JorgenSteen/BreakoutBodger-2-electric-boogaloo/Atmega_328_breakout.png

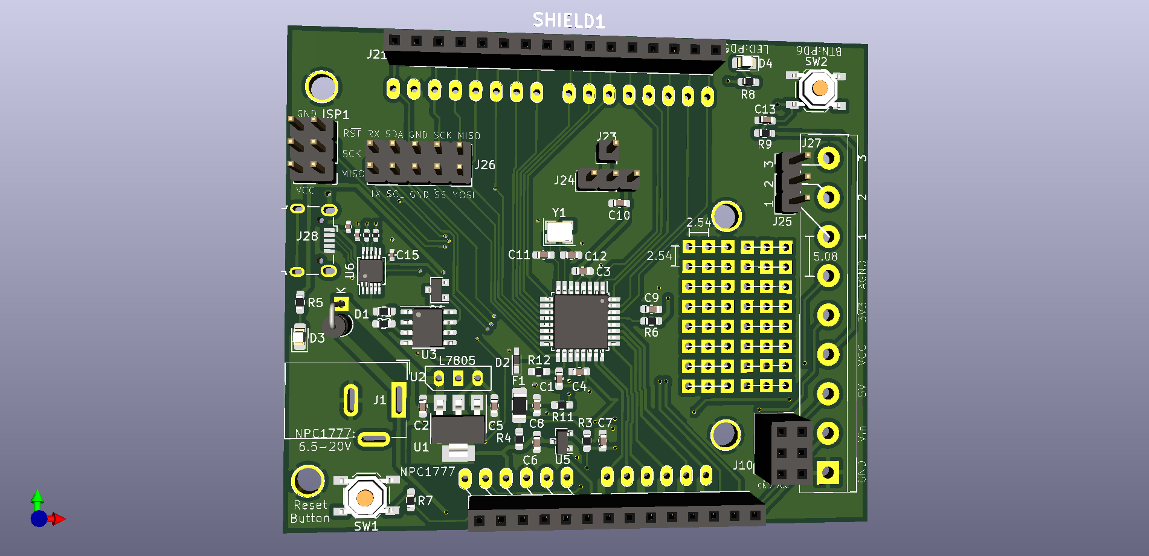
Atmega_328_breakout.png
