JorgenSteen/BreakoutBodger-2-electric-boogaloo/src/Kicad/report.txt

Updated GND from #PWR27 to #PWR027
Updated GND from #PWR19 to #PWR019
Updated VCC from #PWR20 to #PWR020
Updated GND from #PWR21 to #PWR021
Updated GND from #PWR22 to #PWR022
Updated GND from #PWR23 to #PWR023
Updated VCC from #PWR24 to #PWR024
Updated GND from #PWR25 to #PWR025
Updated GND from #PWR26 to #PWR026
Updated VCC from #PWR18 to #PWR018
Updated GND from #PWR28 to #PWR028
Updated VCC from #PWR29 to #PWR029
Updated GND from #PWR30 to #PWR030
Updated GND from #PWR31 to #PWR031
Updated VCC from #PWR32 to #PWR032
Updated GND from #PWR33 to #PWR033
Updated GND from #PWR34 to #PWR034
Updated GND from #PWR10 to #PWR010
Updated GND from #PWR2 to #PWR02
Updated GND from #PWR3 to #PWR03
Updated VCC from #PWR4 to #PWR04
Updated GND from #PWR5 to #PWR05
Updated GND from #PWR6 to #PWR06
Updated +5V from #PWR7 to #PWR07
Updated +5V from #PWR8 to #PWR08
Updated GND from #PWR9 to #PWR09
Updated GND from #PWR1 to #PWR01
Updated +5V from #PWR11 to #PWR011
Updated +5V from #PWR12 to #PWR012
Updated +3.3V from #PWR13 to #PWR013
Updated GND from #PWR14 to #PWR014
Updated GND from #PWR15 to #PWR015
Updated +3.3V from #PWR16 to #PWR016
Updated +5V from #PWR17 to #PWR017
