JorgenSteen/BreakoutBodger-2-electric-boogaloo/3D print box/BB_case_top.stl

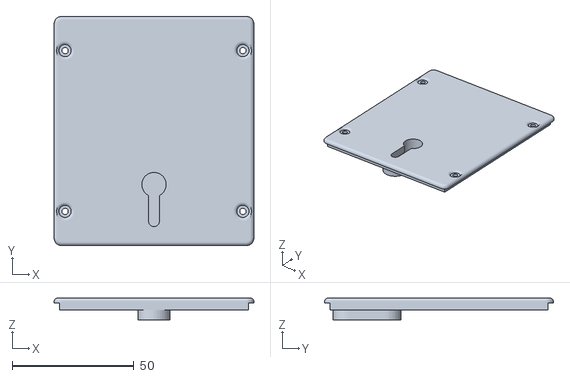
[picture p3: CAD file, 2020-11-07]
3D print box/BB_case_top.stl
82.0 x 94.0 x 9.00
