JorgenSteen/BreakoutBodger-2-electric-boogaloo/(list of files, cad)

Other CAD files:
src/Fusion360/BreakoutBodger_case v66.f3d
