JorgenSteen/BreakoutBodger-2-electric-boogaloo/Schematics.pdf

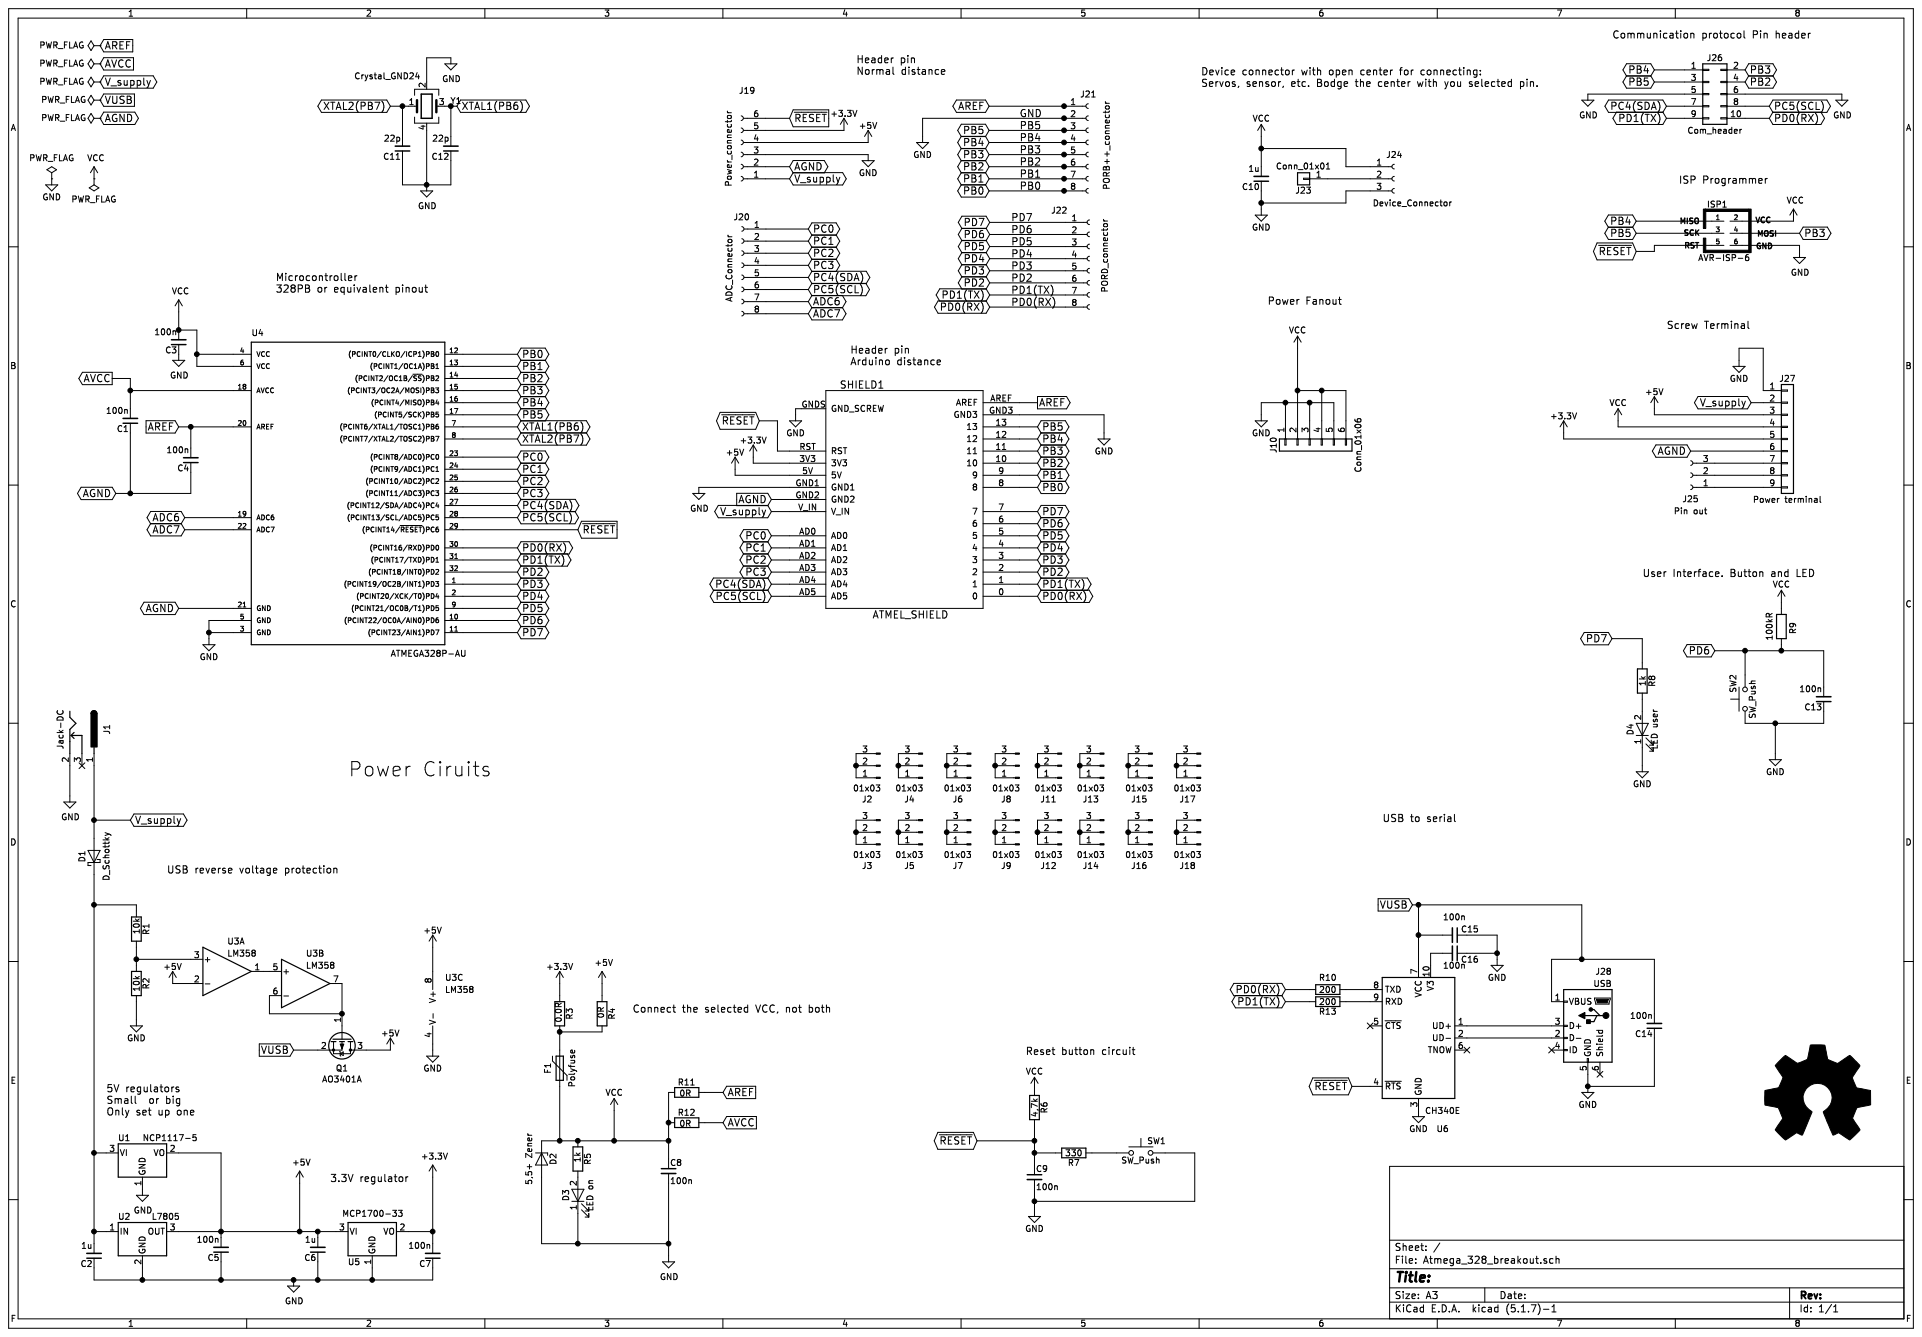
[picture p4: page 1]
