JorgenSteen/BreakoutBodger-2-electric-boogaloo/src/Kicad/Atmega_328_breakout.kicad_pcb

## KiCad design src/Kicad/Atmega_328_breakout.kicad_pcb (2020-11-07)

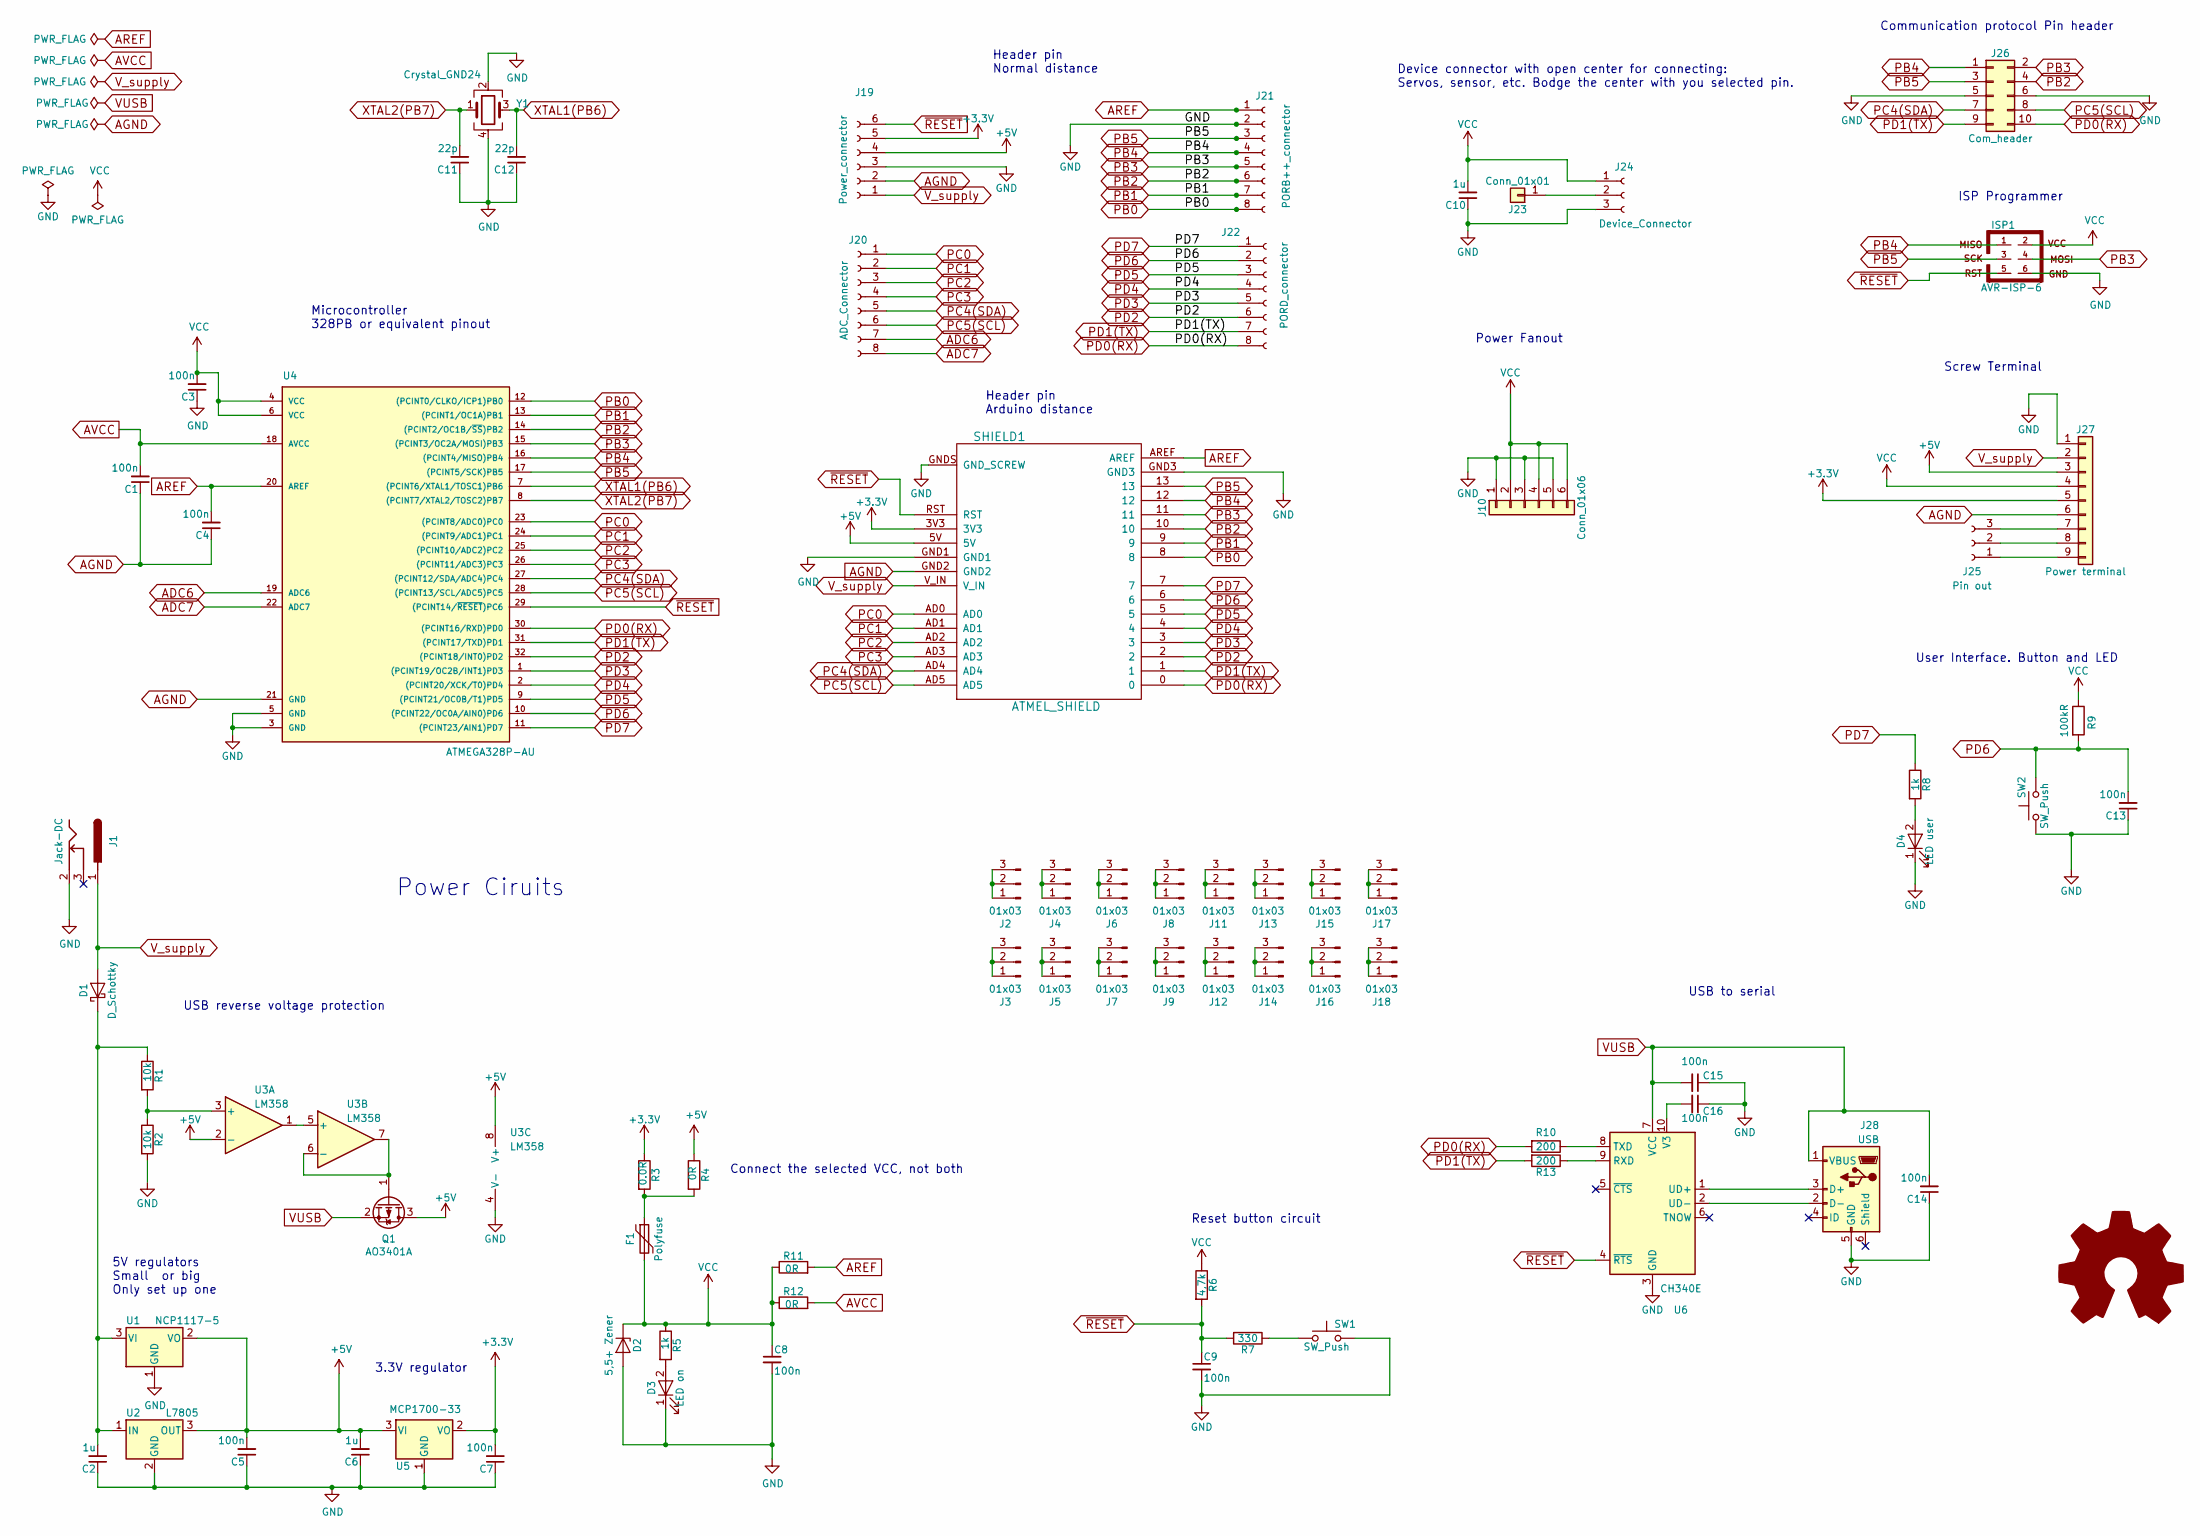
[picture p5: schematic Atmega_328_breakout.sch]

Parts:
C1, C3, C4, C5, C7, C8, C9, C13: 100n; C_0603_1608Metric_Pad1.08x0.95mm_HandSolder; LCSC C14663
C2, C6, C10: 1u; C_0603_1608Metric_Pad1.08x0.95mm_HandSolder; LCSC C15849
C11, C12: 22p; C_0603_1608Metric_Pad1.08x0.95mm_HandSolder; LCSC C1653
C14, C15, C16: 100n; C_0402_1005Metric; LCSC C1525
D1: D_Schottky; D_A-405_P2.54mm_Vertical_KathodeUp
D2: 5,5+ Zener; D_SC-80_HandSoldering; LCSC C8062
D3: LED on; LED_0805_2012Metric_Pad1.15x1.40mm_HandSolder; LCSC C2297
D4: LED user; LED_0805_2012Metric_Pad1.15x1.40mm_HandSolder; LCSC C2293
F1: Polyfuse; Fuse_1206_3216Metric_Pad1.42x1.75mm_HandSolder; LCSC C66453
ISP1: AVR-ISP-6; PinHeader_2x03_P2.54mm_Vertical
J1: Jack-DC; BarrelJack_Wuerth_6941xx301002
J2, J3, J4, J5, J6, J7, J8, J9, J11, J12, J13, J14, J15, J16, J17, J18: 01x03; conn_01x03_square
J10: Conn_01x06; PinSocket_2x03_P2.54mm_Vertical
J19: Power_connector; PinSocket_1x06_P2.54mm_Vertical
J20: ADC_Connector; PinSocket_1x08_P2.54mm_Vertical
J21: PORB++_connector; PinSocket_1x08_P2.54mm_Vertical
J22: PORD_connector; PinSocket_1x08_P2.54mm_Vertical
J23: Conn_01x01; PinHeader_1x01_P2.54mm_Vertical
J24: Device_Connector; PinHeader_1x03_P2.54mm_Vertical
J25: Pin out; PinHeader_1x03_P2.54mm_Vertical
J26: Com_header; PinHeader_2x05_P2.54mm_Vertical
J27: Power terminal; TerminalBlock_bornier-9_P5.08mm
J28: USB; USB_Micro-B_Wuerth_629105150521
LOGO1: Logo_Open_Hardware_Large; BB2QR
Q1: AO3401A; SOT-23; LCSC C15127
R1, R2: 10k; R_0603_1608Metric_Pad0.98x0.95mm_HandSolder; LCSC C25804
R3: 0.0R; R_0603_1608Metric_Pad0.98x0.95mm_HandSolder
R4, R11, R12: 0R; R_0603_1608Metric_Pad0.98x0.95mm_HandSolder; LCSC C21189
R5, R8: 1k; R_0603_1608Metric_Pad0.98x0.95mm_HandSolder; LCSC C21190
R6: 4,7k; R_0603_1608Metric_Pad0.98x0.95mm_HandSolder; LCSC C23162
R7: 330; R_0603_1608Metric_Pad0.98x0.95mm_HandSolder; LCSC C23138
R9: 100kR; R_0603_1608Metric_Pad0.98x0.95mm_HandSolder; LCSC C25803
R10, R13: 200; R_0402_1005Metric; LCSC C25087
SHIELD1: ATMEL_SHIELD; AtmelSHIELD
SW1, SW2: SW_Push; SW_SPST_TL3342; LCSC C318887
U1: NCP1117-5; SOT-223-3_TabPin2; LCSC C17314
U2: L7805; TO-220-ver2
U3: LM358; SOIC-8_3.9x4.9mm_P1.27mm; LCSC C7950
U4: ATMEGA328P-AU; TQFP-32_7x7mm_P0.8mm; LCSC C14877
U5: MCP1700-33; SOT-23; LCSC C62244
U6: CH340E; MSOP-10_3x3mm_P0.5mm
Y1: Crystal_GND24; Crystal_SMD_3225-4Pin_3.2x2.5mm; LCSC C13738

Connections:
+3V3: C7.2, J19.5, J27.5, R3.1, SHIELD1.3V3, U5.2 (VO)
+5V: C5.2, C6.2, J19.4, J27.3, Q1.3 (D), R4.1, SHIELD1.5V, U1.2 (VO), U2.3 (OUT), U3.2 (-), U3.8 (V+), U5.3 (VI)
ADC6: J20.7, U4.19 (ADC6)
ADC7: J20.8, U4.22 (ADC7)
AGND: C1.1, C4.1, J19.2, J27.6, SHIELD1.GND2, U4.21 (GND)
AREF: C4.2, J21.1, R11.2, SHIELD1.AREF, U4.20 (AREF)
AVCC: C1.2, R12.2, U4.18 (AVCC)
GND: C2.1, C3.1, C5.1, C6.1, C7.1, C8.2, C9.2, C10.1, C11.1, C12.1, C13.1, C14.1, C15.1, C16.1, D2.2 (A), D3.1 (K), D4.1 (K), ISP1.6, J1.2, J10.1, J10.3, J10.5, J19.3, J21.2, J24.3, J26.5, J26.6, J27.1, J28.5 (GND), R2.2, SHIELD1.GND1, SHIELD1.GND3, SHIELD1.GNDS (GND_SCREW), SW1.2, SW2.1, U1.1 (GND), U2.2 (GND), U3.4 (V-), U4.3 (GND), U4.5 (GND), U5.1 (GND), U6.3 (GND), Y1.2, Y1.4
unnamed: C2.2, D1.1 (K), R1.1, U1.3 (VI), U2.1 (IN)
unnamed: C16.2, U6.10 (V3)
unnamed: D3.2 (A), R5.2
unnamed: D4.2 (A), R8.2
unnamed: F1.1, R3.2, R4.2
unnamed: J2.1, J2.2, J2.3
unnamed: J3.1, J3.2, J3.3
unnamed: J4.1, J4.2, J4.3
unnamed: J5.1, J5.2, J5.3
unnamed: J6.1, J6.2, J6.3
unnamed: J7.1, J7.2, J7.3
unnamed: J8.1, J8.2, J8.3
unnamed: J9.1, J9.2, J9.3
unnamed: J11.1, J11.2, J11.3
unnamed: J12.1, J12.2, J12.3
unnamed: J13.1, J13.2, J13.3
unnamed: J14.1, J14.2, J14.3
unnamed: J15.1, J15.2, J15.3
unnamed: J16.1, J16.2, J16.3
unnamed: J17.1, J17.2, J17.3
unnamed: J18.1, J18.2, J18.3
unnamed: J23.1, J24.2
unnamed: J25.1, J27.9
unnamed: J25.2, J27.8
unnamed: J25.3, J27.7
unnamed: J28.2 (D-), U6.2 (UD-)
unnamed: J28.3 (D+), U6.1 (UD+)
unnamed: Q1.1 (G), U3.6 (-), U3.7
unnamed: R1.2, R2.1, U3.3 (+)
unnamed: R7.1, SW1.1
unnamed: R10.1, U6.8 (TXD)
unnamed: R13.1, U6.9 (RXD)
unnamed: U3.1, U3.5 (+)
PB0: J21.8, SHIELD1.8, U4.12 ((PCINT0/CLKO/ICP1)PB0)
PB1: J21.7, SHIELD1.9, U4.13 ((PCINT1/OC1A)PB1)
PB2: J21.6, J26.4, SHIELD1.10, U4.14 ((PCINT2/OC1B/~SS~)PB2)
PB3: ISP1.4, J21.5, J26.2, SHIELD1.11, U4.15 ((PCINT3/OC2A/MOSI)PB3)
PB4: ISP1.1, J21.4, J26.1, SHIELD1.12, U4.16 ((PCINT4/MISO)PB4)
PB5: ISP1.3, J21.3, J26.3, SHIELD1.13, U4.17 ((PCINT5/SCK)PB5)
PC0: J20.1, SHIELD1.AD0, U4.23 ((PCINT8/ADC0)PC0)
PC1: J20.2, SHIELD1.AD1, U4.24 ((PCINT9/ADC1)PC1)
PC2: J20.3, SHIELD1.AD2, U4.25 ((PCINT10/ADC2)PC2)
PC3: J20.4, SHIELD1.AD3, U4.26 ((PCINT11/ADC3)PC3)
PC4(SDA): J20.5, J26.7, SHIELD1.AD4, U4.27 ((PCINT12/SDA/ADC4)PC4)
PC5(SCL): J20.6, J26.8, SHIELD1.AD5, U4.28 ((PCINT13/SCL/ADC5)PC5)
PD0(RX): J22.8, J26.10, R10.2, SHIELD1.0, U4.30 ((PCINT16/RXD)PD0)
PD1(TX): J22.7, J26.9, R13.2, SHIELD1.1, U4.31 ((PCINT17/TXD)PD1)
PD2: J22.6, SHIELD1.2, U4.32 ((PCINT18/INT0)PD2)
PD3: J22.5, SHIELD1.3, U4.1 ((PCINT19/OC2B/INT1)PD3)
PD4: J22.4, SHIELD1.4, U4.2 ((PCINT20/XCK/T0)PD4)
PD5: J22.3, SHIELD1.5, U4.9 ((PCINT21/OC0B/T1)PD5)
PD6: C13.2, J22.2, R9.2, SHIELD1.6, SW2.2, U4.10 ((PCINT22/OC0A/AIN0)PD6)
PD7: J22.1, R8.1, SHIELD1.7, U4.11 ((PCINT23/AIN1)PD7)
VCC: C3.2, C8.1, C10.2, D2.1 (K), F1.2, ISP1.2, J10.2, J10.4, J10.6, J24.1, J27.4, R5.1, R6.1, R9.1, R11.1, R12.1, U4.4 (VCC), U4.6 (VCC)
VUSB: C14.2, C15.2, J28.1 (VBUS), Q1.2 (S), U6.7 (VCC)
V_supply: D1.2 (A), J1.1, J19.1, J27.2, SHIELD1.V_IN
XTAL1(PB6): C12.2, U4.7 ((PCINT6/XTAL1/TOSC1)PB6), Y1.3
XTAL2(PB7): C11.2, U4.8 ((PCINT7/XTAL2/TOSC2)PB7), Y1.1
~RESET: C9.1, ISP1.5, J19.6, R6.2, R7.2, SHIELD1.RST, U4.29 ((PCINT14/~RESET~)PC6), U6.4 (~RTS)

Notes on the sheet:
User Interface. Button and LED
Screw Terminal
ISP Programmer
Communication protocol Pin header
Reset button circuit
Connect the selected VCC, not both
USB reverse voltage protection
Power Ciruits
5V regulators Small or big Only set up one
3.3V regulator
Microcontroller 328PB or equivalent pinout
Header pin Arduino distance
Header pin Normal distance
Device connector with open center for connecting: Servos, sensor, etc. Bodge the center with you selected pin.
Power Fanout
USB to serial

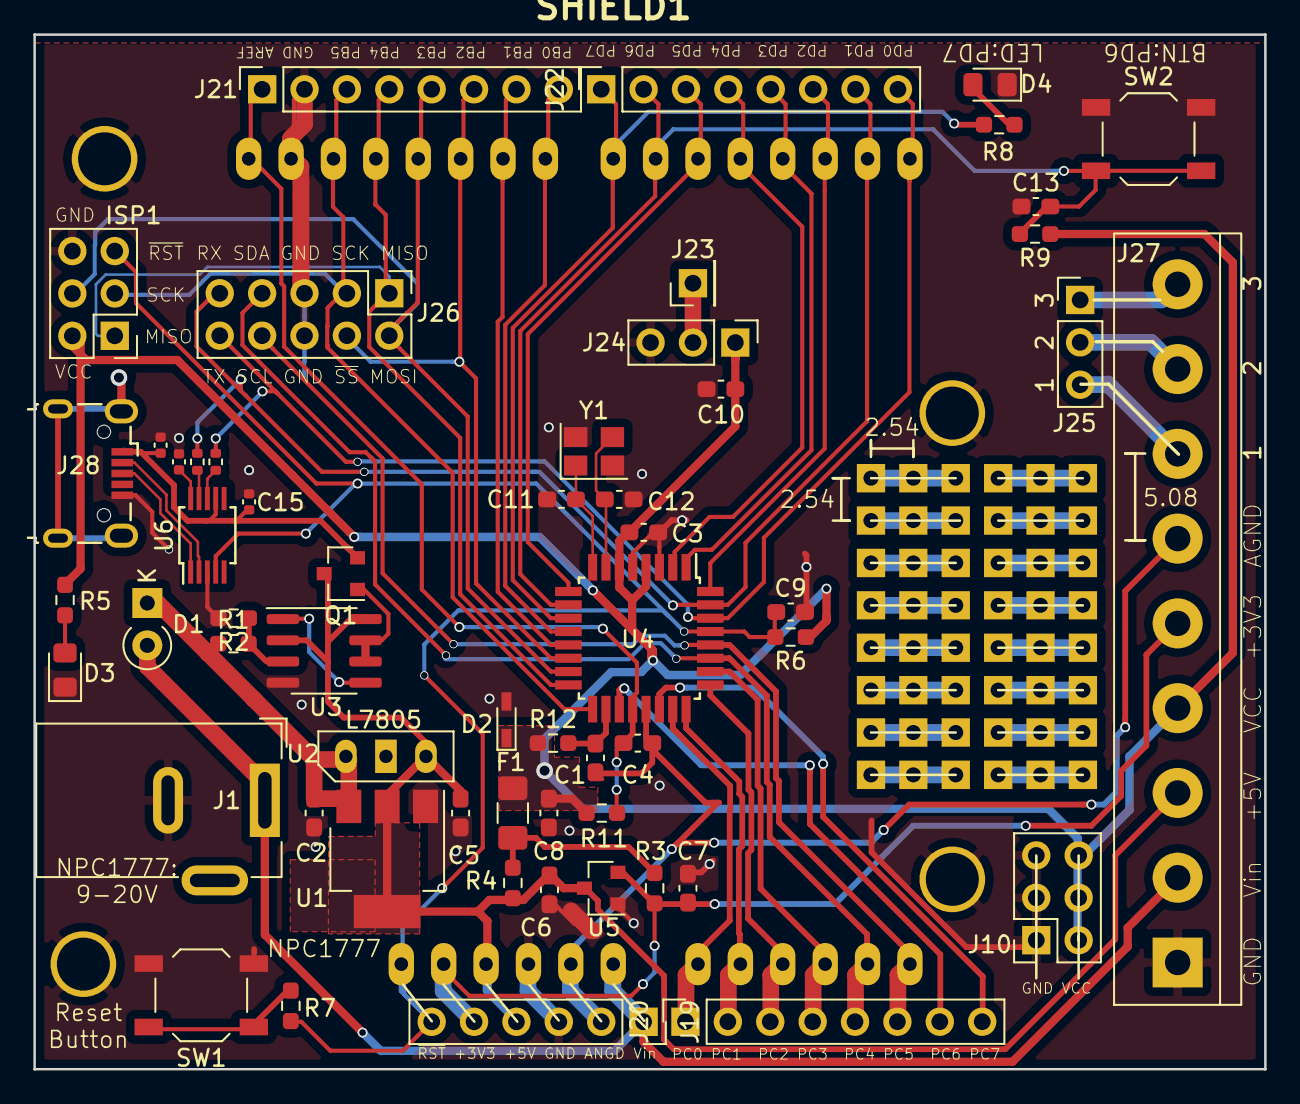
[picture p6: board Atmega_328_breakout.kicad_pcb from above]

Board: 2 copper layers, 73.8 x 62.0 mm, 75 parts (1 on the bottom side), 67 nets.
