JorgenSteen/BreakoutBodger-2-electric-boogaloo/TODO.txt

flip Silkscreen bak

Lag et tydelig merk for retningen til MCU

Bytt USB footprint

replace reverse polarity diode with SMD

add posibility to connect reset button somewhere else
	- move C9 and R6 and place a cutable trace to enable debugWire.
