JorgenSteen/BreakoutBodger-2-electric-boogaloo/(commit log)

2020-10-14 intial push
    [Atmega_328_breakout-B.Cu.gbr, Atmega_328_breakout-B.Mask.gbr, Atmega_328_breakout-B.Paste.gbr, Atmega_328_breakout-B.SilkS.gbr, Atmega_328_breakout-Edge.Cuts.gbr, Atmega_328_breakout-F.Cu.gbr, Atmega_328_breakout-F.Mask.gbr, Atmega_328_breakout-F.Paste.gbr]
2020-10-16 initial push
    [Atmega_328_breakout-2020-10-14-18-51-54.sch, Atmega_328_breakout-2020-10-14-19-22-31.sch, Atmega_328_breakout-2020-10-14-19-28-37.sch]
2020-10-17 fixed it for kicad 5
    [Atmega_328_breakout-2020-10-14-18-51-54.sch, Atmega_328_breakout-2020-10-14-19-22-31.sch, Atmega_328_breakout-2020-10-14-19-28-37.sch, Atmega_328_breakout.kicad_pcb]
2020-10-17 last commit before merge
    [Atmega_328_breakout.csv, Atmega_328_breakout.kicad_pcb, Atmega_328_breakout.sch]
2020-10-17 double checked files
    [Atmega_328_breakout.kicad_pcb, Atmega_328_breakout.sch]
2020-10-17 copied edited files
    [Atmega_328_breakout.kicad_pcb, Atmega_328_breakout.sch]
2020-10-17 added available parts from jlcpcb for bom
    [Atmega_328_breakout (2).csv, Atmega_328_breakout.csv, Atmega_328_breakout.kicad_pcb, Atmega_328_breakout.sch]
2020-10-17 compiled and packed gerber
    [Atmega_328_breakout-B_Cu.gbr, Atmega_328_breakout-B_Mask.gbr, Atmega_328_breakout-B_Paste.gbr, Atmega_328_breakout-B_SilkS.gbr, Atmega_328_breakout-Edge_Cuts.gbr, Atmega_328_breakout-F_Cu.gbr, Atmega_328_breakout-F_Mask.gbr, Atmega_328_breakout-F_Paste.gbr]
2020-10-17 replace as much as possible with smd
    [Atmega_328_breakout.kicad_pcb]
2020-10-18 All parts added and part number
    [Atmega_328_breakout.csv, Atmega_328_breakout.kicad_pcb, Atmega_328_breakout.sch]
2020-10-18 before switching
    [Atmega_328_breakout.csv, Atmega_328_breakout.sch, QR_DD2.dxf]
2020-10-18 Every thing is placed and files are created.
    [Atmega_328_breakout (2).csv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]
2020-10-18 updated scheme
    [Atmega_328_breakout.csv, Atmega_328_breakout.kicad_pcb, Atmega_328_breakout.sch]
2020-10-18 sent for production
    [Atmega_328_breakout-B_Cu.gbr, Atmega_328_breakout-B_Mask.gbr, Atmega_328_breakout-B_Paste.gbr, Atmega_328_breakout-B_SilkS.gbr, Atmega_328_breakout-Edge_Cuts.gbr, Atmega_328_breakout-F_Cu.gbr, Atmega_328_breakout-F_Mask.gbr, Atmega_328_breakout-F_Paste.gbr]
2020-10-20 replaced serial to usb chip and added safety.
    [Atmega_328_breakout-B.Cu.gbr, Atmega_328_breakout-B.Mask.gbr, Atmega_328_breakout-B.Paste.gbr, Atmega_328_breakout-B.SilkS.gbr, Atmega_328_breakout-B_Cu.gbr, Atmega_328_breakout-B_Mask.gbr, Atmega_328_breakout-B_Paste.gbr, Atmega_328_breakout-B_SilkS.gbr]
2020-11-07 clean up and added test code and box
    [Atmega_328_breakout-B_Cu.gbr, Atmega_328_breakout-B_Mask.gbr, Atmega_328_breakout-B_Paste.gbr, Atmega_328_breakout-B_SilkS.gbr, Atmega_328_breakout-Edge_Cuts.gbr, Atmega_328_breakout-F_Cu.gbr, Atmega_328_breakout-F_Mask.gbr, Atmega_328_breakout-F_Paste.gbr]
2020-11-07 added arduino code
2020-11-14 added fusion360 schemtic for box
    [BreakoutBodger_case v66.f3d]
